sulaolab/EasyEDA-WM8904-mikroBUS/WM8904_mikroBUS_04/WM8904_mikroBUS_04_front.png

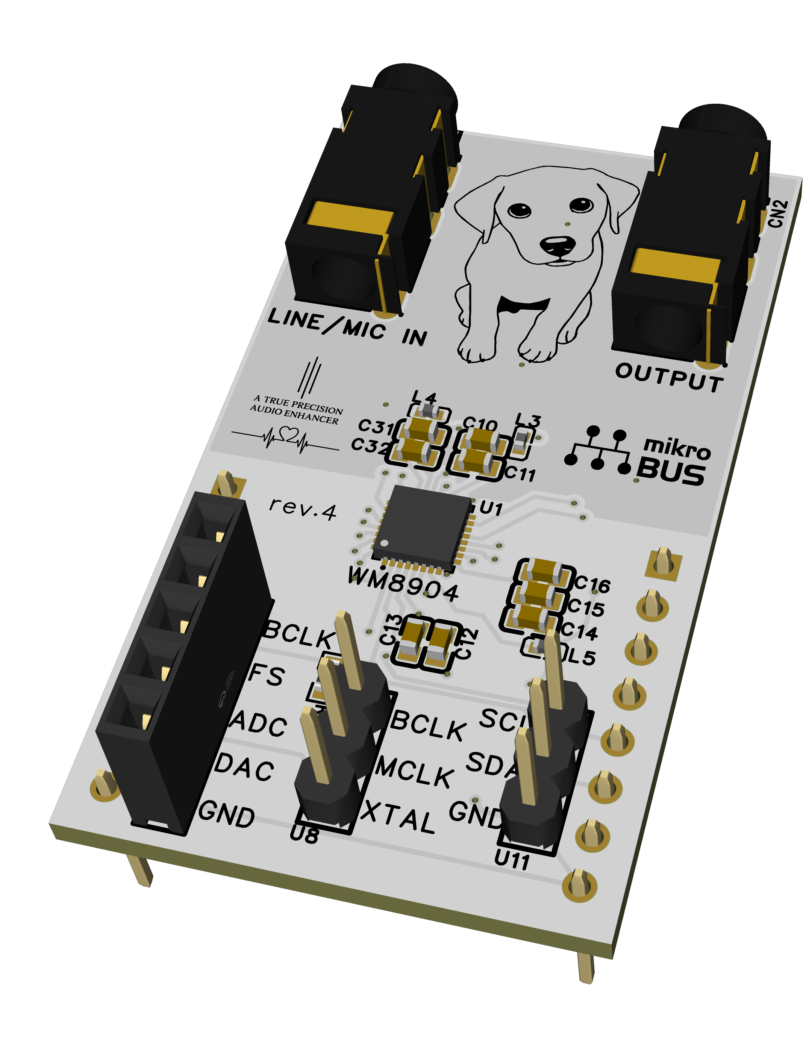
WM8904_mikroBUS_04/WM8904_mikroBUS_04_front.png
