sulaolab/EasyEDA-WM8904-mikroBUS/WM8904_mikroBUS_05/WM8904_mikroBUS_05_sch.pdf

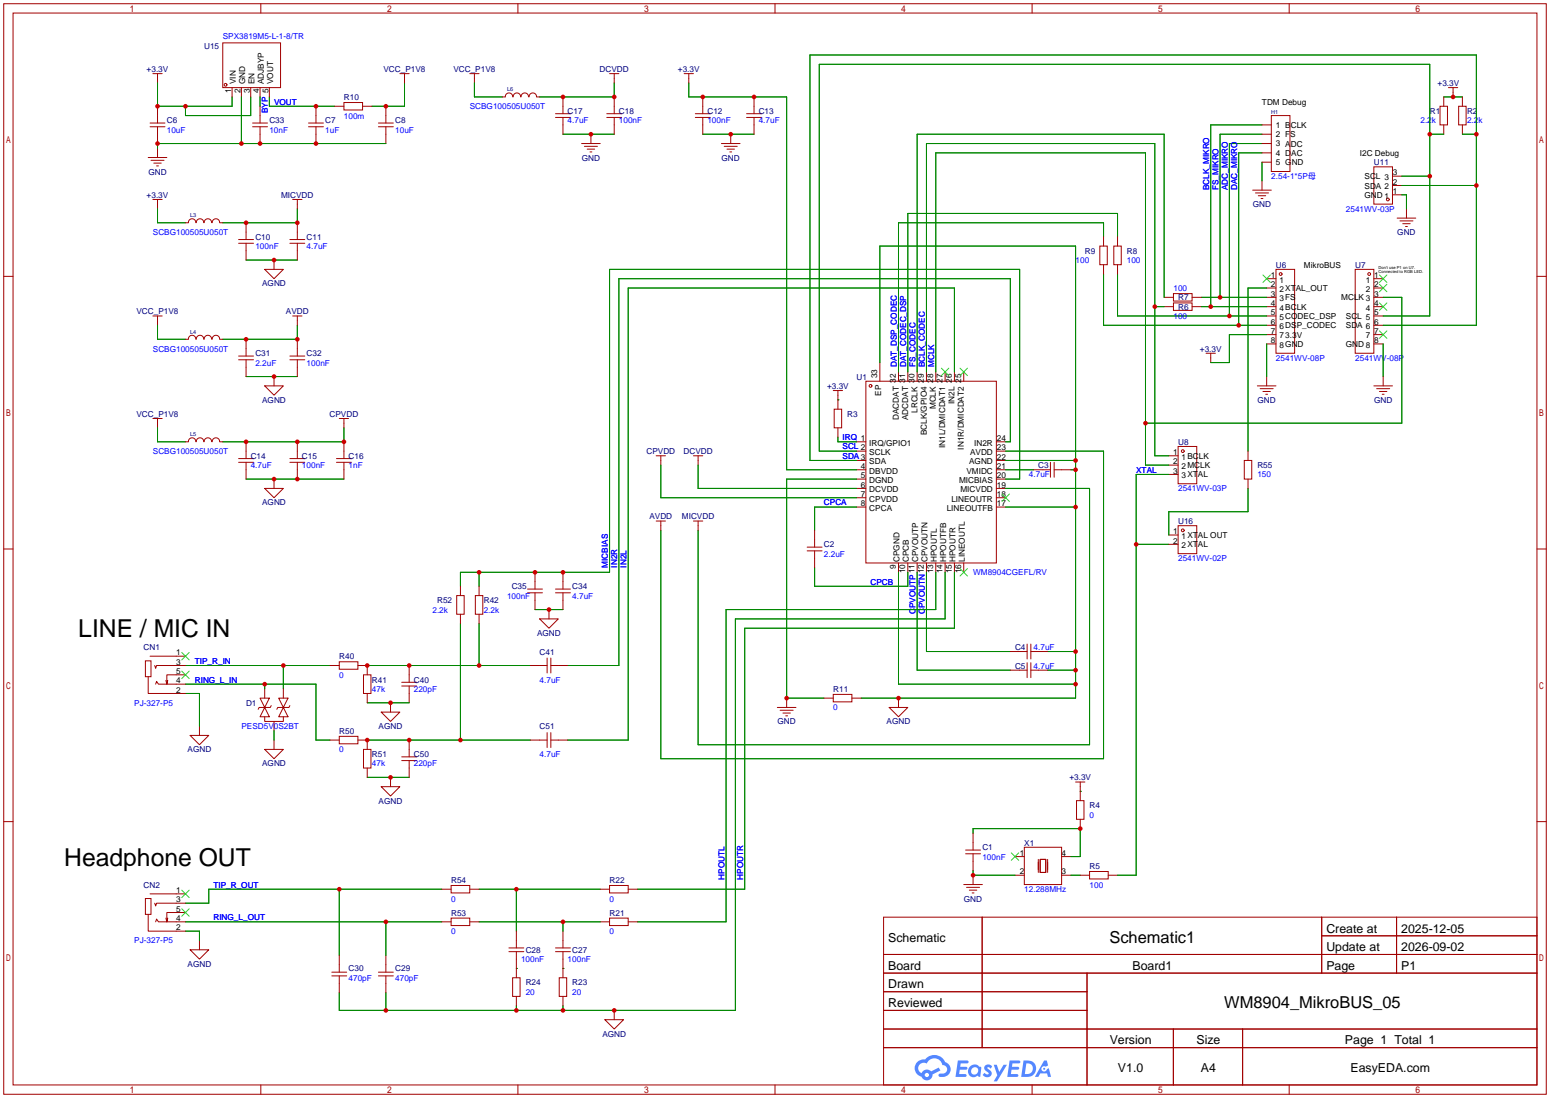
[picture p5: page 1]

Don't use P1 on U7.
Connected to RGB LED.

DAT_CODEC_DSP
LINEOUTFB 17 LINEOUTR 18 MICVDD 19 MICBIAS 20 VMIDC 21 AGND 22 AVDD 23 IN2R 24 IN¹R/DMICDAT2 25 IN²L 26

Schematic | Schematic1 | Create at | 2025-12-05

Update at | 2026-09-02

Board | Board1 | Page | P1
Drawn | | WM8904_MikroBUS_05
Reviewed

Version | Size | Page 1 Total 1
V1.0 | A4 | EasyEDA.com
