sulaolab/EasyEDA-WM8904-mikroBUS/(list of files, drawings)

Other design files:
WM8904_mikroBUS_04/WM8904_mikroBUS_04.eprj
WM8904_mikroBUS_05/WM8904_mikroBUS_05.eprj
