sulaolab/EasyEDA-WM8904-mikroBUS/(commit log)

2026-08-14 Publish EasyEDA WM8904 mikroBUS board designs (rev.04, rev.05)
    Initial import of the EasyEDA project files and the exported reference
    documents (schematic PDF, front/back PCB renders) for the WM8904 mikroBUS
    stereo audio codec add-on board.
    - rev.04: built and verified on hardware; MICBIAS connection added; known
    issue: Left/Right swapped on both the input and the output path
    - rev.05: planned, not yet built; L/R swap fixed; jumper added to drive the
    XTAL clock out to an external pin
    - CC0 1.0 dedication, with carve-outs for third-party libraries, reference
    designs and trademarks, and provenance notes for the silkscreen artwork
    - README in English and Japanese, including mikroBUS stan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
    [WM8904_mikroBUS_04.eprj, WM8904_mikroBUS_05.eprj]
2026-09-15 rev.05: mark built and verified on hardware
    The rev.05 board was fabricated and brought up successfully. Update the
    project files to the as-built design and re-state its status in the README.
    Design (as fabricated, EasyEDA project of 2026-09-02):
    - XTAL_OUT moved from mikroBUS pin 1 to pin 2; pin 1 is wired to an RGB LED
    on some mainboards. Note added to the schematic.
    - Schematic PDF re-exported from the as-built project.
    README:
    - rev.05 status: "planned, not yet built" -> "built, verified on hardware",
    in the hero caption, the Revisions section and the Projects table (EN + JA).
    - Record that the Left/Right fix and the XTAL clock output jumper were both
    verified on hardware, and th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
    [WM8904_mikroBUS_05.eprj]
